insu5177/temperature-compensated-mosfet-current-sensing/results/figures/u1_schematic.png

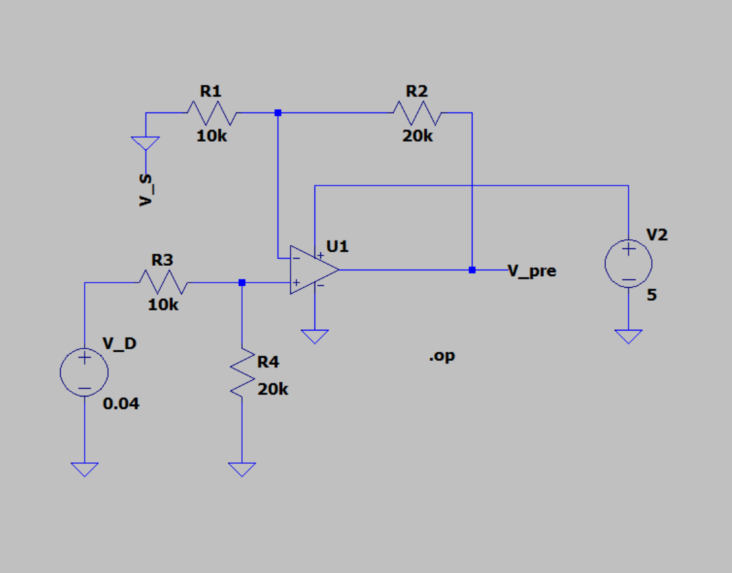
results/figures/u1_schematic.png
