insu5177/temperature-compensated-mosfet-current-sensing/circuits/vds_sensing/u1_vds_sensing(offset -1V).asc

R1: res; 10k
R2: res; 20k
R3: res; 10k
R4: res; 20k
U1: UniversalOpAmp2
V1: voltage; 5
V_D1: voltage; 0.04
Vos1: voltage; -1
Named nets: 0, V_S, V_pre
.op
