insu5177/temperature-compensated-mosfet-current-sensing/circuits/compensated_system/compensated_system.asc

R1: res; 10k
R2: res; 20k
R3: res; 10k
R4: res; 20k
R5: res; 718
R6: res; {10k*exp(3950*(1/(Ts+273.15)-1/298.15))}
R7: res; 528
U1: UniversalOpAmp2
U2: UniversalOpAmp2
V2: voltage; 5
V_D: voltage; 0.15
Named nets: 0, V_S, V_pre, V_final
.op
.step param Ts list 25 50 75 100 125 150 175
.meas op Vpre_value PARAM V(V_pre)
.meas op Vfinal_value PARAM V(V_final)
