insu5177/temperature-compensated-mosfet-current-sensing/circuits/ntc_compensation/ntc_compensation.asc

R1: res; 718
R2: res; 528
RNTC: res; {10k*exp(3950*(1/(temp+273.15)-1/298.15))}
V1: voltage; 1
Named nets: 0, Vcomp
.op
.step param temp list 25 50 75 100 125 150 175
.meas op Vcomp_value FIND V(vcomp)
