insu5177/temperature-compensated-mosfet-current-sensing/circuits/vds_sensing/u1_vds_sensing.asc

R1: res; 10k
R2: res; 20k
R3: res; 10k
R4: res; 20k
U1: UniversalOpAmp2
V2: voltage; 5
V_D: voltage; 0.04
Named nets: 0, V_S, V_pre
.op
