insu5177/temperature-compensated-mosfet-current-sensing/data/processed/integrated_test_inputs.csv

I_true (A) | Tc (°C) | Tj (°C) | Ts (°C) | VDS (V)
25 | 25 | 25.3919463625 | 25.3919463625 | 0.0373283892725
25 | 50 | 50.44465214097736 | 50.44465214097736 | 0.042347823471015
25 | 75 | 75.50274749044773 | 75.50274749044773 | 0.0478807143475164
25 | 100 | 100.57124446507927 | 100.57124446507927 | 0.0544042360055714
25 | 125 | 125.64252393036124 | 125.64252393036124 | 0.0611927571791083
25 | 150 | 150.72182688926932 | 150.72182688926932 | 0.0687454211423515
50 | 25 | 26.57775219112 | 26.57775219112 | 0.075131100876448
50 | 50 | 51.7910478825512 | 51.7910478825512 | 0.0852880610683225
50 | 75 | 77.0276392086552 | 77.0276392086552 | 0.0965543723885007
50 | 100 | 102.3046311950746 | 102.3046311950746 | 0.1097445008453402
50 | 125 | 127.59468794312 | 127.59468794312 | 0.123556812765872
50 | 150 | 152.9186702332368 | 152.9186702332368 | 0.138984695758601
75 | 25 | 28.58793655166204 | 28.58793655166204 | 0.1139027619309972
75 | 50 | 54.07739325998212 | 54.07739325998212 | 0.1294410795515882
75 | 75 | 79.62603503637426 | 79.62603503637426 | 0.1468583073283719
75 | 100 | 105.2608535043942 | 105.2608535043942 | 0.1670112913385592
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
