insu5177/temperature-compensated-mosfet-current-sensing/data/processed/mosfet_test_cases.csv

I_true (A) | Tc (°C) | Tj (°C) | Rds (mΩ) | Ploss (W) | VDS (V) | I_fixed (A) | Error (A) | Error (%)
25 | 25 | 25.3919463625 | 1.4931355709 | 0.9332097318125 | 0.0373283892725 | 25.052610249999997 | 0.052610249999997194 | 0.21044099999998878
25 | 50 | 50.44465214097736 | 1.6939129388406007 | 1.0586955867753753 | 0.04234782347101502 | 28.421358034238267 | 3.421358034238267 | 13.685432136953068
25 | 75 | 75.50274749044773 | 1.9152285739006563 | 1.19701785868791 | 0.04788071434751641 | 32.13470761578282 | 7.134707615782823 | 28.538830463131294
25 | 100 | 100.57124446507929 | 2.176169440222856 | 1.3601059001392852 | 0.054404236005571406 | 36.512910070853295 | 11.512910070853295 | 46.05164028341318
25 | 125 | 125.64252393036125 | 2.447710287164335 | 1.5298189294777094 | 0.061192757179108374 | 41.06896454973717 | 16.068964549737167 | 64.27585819894867
25 | 150 | 150.72182688926932 | 2.749816845694063 | 1.7186355285587893 | 0.06874542114235158 | 46.13786653849099 | 21.13786653849099 | 84.55146615396396
50 | 25 | 26.57775219112 | 1.50262201752896 | 3.7565550438224 | 0.075131100876448 | 50.423557635200005 | 0.4235576352000052 | 0.8471152704000104
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
