insu5177/temperature-compensated-mosfet-current-sensing/results/tables/abc_24case_comparison.csv

I_true (A) | Tc (°C) | I_est_A | 오차_A(A) | 오차율_A(%) | I_est_B | 오차_B(A) | 오차율_B(%) | I_est_C_Tj | 오차_C_Tj(A) | 오차율_C_Tj(%)
25 | 25 | 25.055100671140938 | 0.05510067114093786 | 0.22040268456375145 | 24.843513964956177 | -0.15648603504382308 | -0.6259441401752923 | 24.9263939458842 | -0.07360605411579968 | -0.2944242164631987
25 | 50 | 28.423825503355705 | 3.4238255033557046 | 13.69530201342282 | 28.183790402544766 | 3.1837904025447656 | 12.735161610179063 | 25.69086885128864 | 0.6908688512886414 | 2.7634754051545656
25 | 75 | 32.13718120805369 | 7.13718120805369 | 28.548724832214763 | 31.865787354677277 | 6.865787354677277 | 27.463149418709108 | 25.14203612479475 | 0.1420361247947497 | 0.5681444991789988
25 | 100 | 36.515436241610736 | 11.515436241610736 | 46.061744966442944 | 36.20706865687533 | 11.207068656875329 | 44.828274627501315 | 24.411865495823516 | -0.5881345041764838 | -2.3525380167059353
25 | 125 | 41.071476510067114 | 16.071476510067114 | 64.28590604026846 | 40.72463382334347 | 15.724633823343467 | 62.89853529337387 | 24.075105304490616 | -0.9248946955093835 | -3.699578782037534
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
