insu5177/temperature-compensated-mosfet-current-sensing/results/tables/sensor_temperature_comparison.csv

I_true (A) | Tc (°C) | I_est_C_Tj | 오차_C_Tj(A) | 오차율_C_Tj(%) | I_est_C_Tc | 오차_C_Tc(A) | 오차율_C_Tc(%)
25 | 25 | 24.9263939458842 | -0.07360605411579968 | -0.2944242164631987 | 24.952880702505894 | -0.04711929749410615 | -0.1884771899764246
25 | 50 | 25.69086885128864 | 0.6908688512886414 | 2.7634754051545656 | 25.747090740344113 | 0.7470907403441132 | 2.9883629613764526
25 | 75 | 25.14203612479475 | 0.1420361247947497 | 0.5681444991789988 | 25.222031841222243 | 0.2220318412222433 | 0.8881273648889733
25 | 100 | 24.411865495823516 | -0.5881345041764838 | -2.3525380167059353 | 24.495002498750623 | -0.5049975012493775 | -2.01999000499751
25 | 125 | 24.075105304490616 | -0.9248946955093835 | -3.699578782037534 | 24.144677661169418 | -0.8553223388305824 | -3.4212893553223296
25 | 150 | 24.6536017705433 | -0.3463982294566996 | -1.3855929178267985 | 24.706825158849146 | -0.29317484115085435 | -1.1726993646034174
50 | 25 | 50.0 | 0.0 | 0.0 | 50.21810523309774 | 0.218105233097738 | 0.43621046619547593
50 | 50 | 51.390376240451204 | 1.3903762404512037 | 2.7807524809024073 | 51.85014635539373 | 1.8501463553937327 | 3.700292710787465
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
