insu5177/temperature-compensated-mosfet-current-sensing/results/error_comparison.png

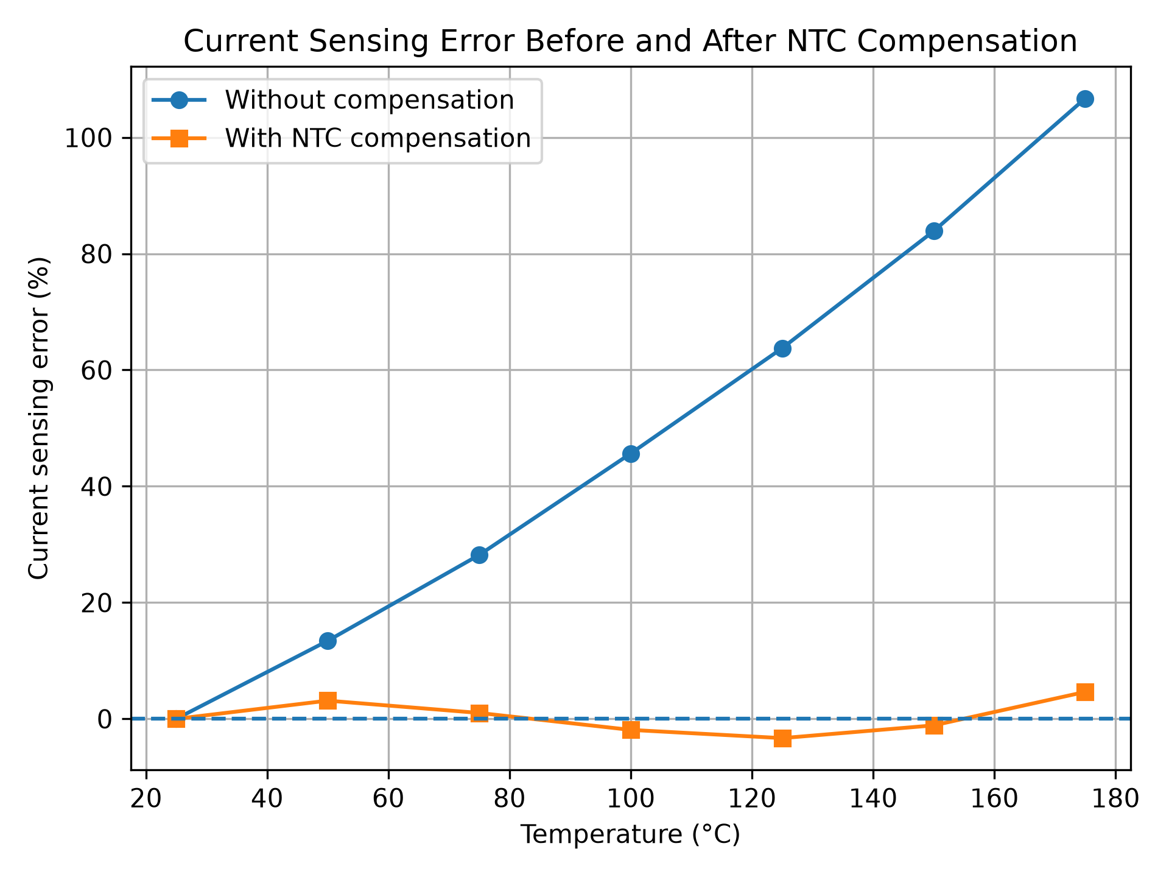
results/error_comparison.png
