insu5177/temperature-compensated-mosfet-current-sensing/results/error_rate_4cases_comparison.png

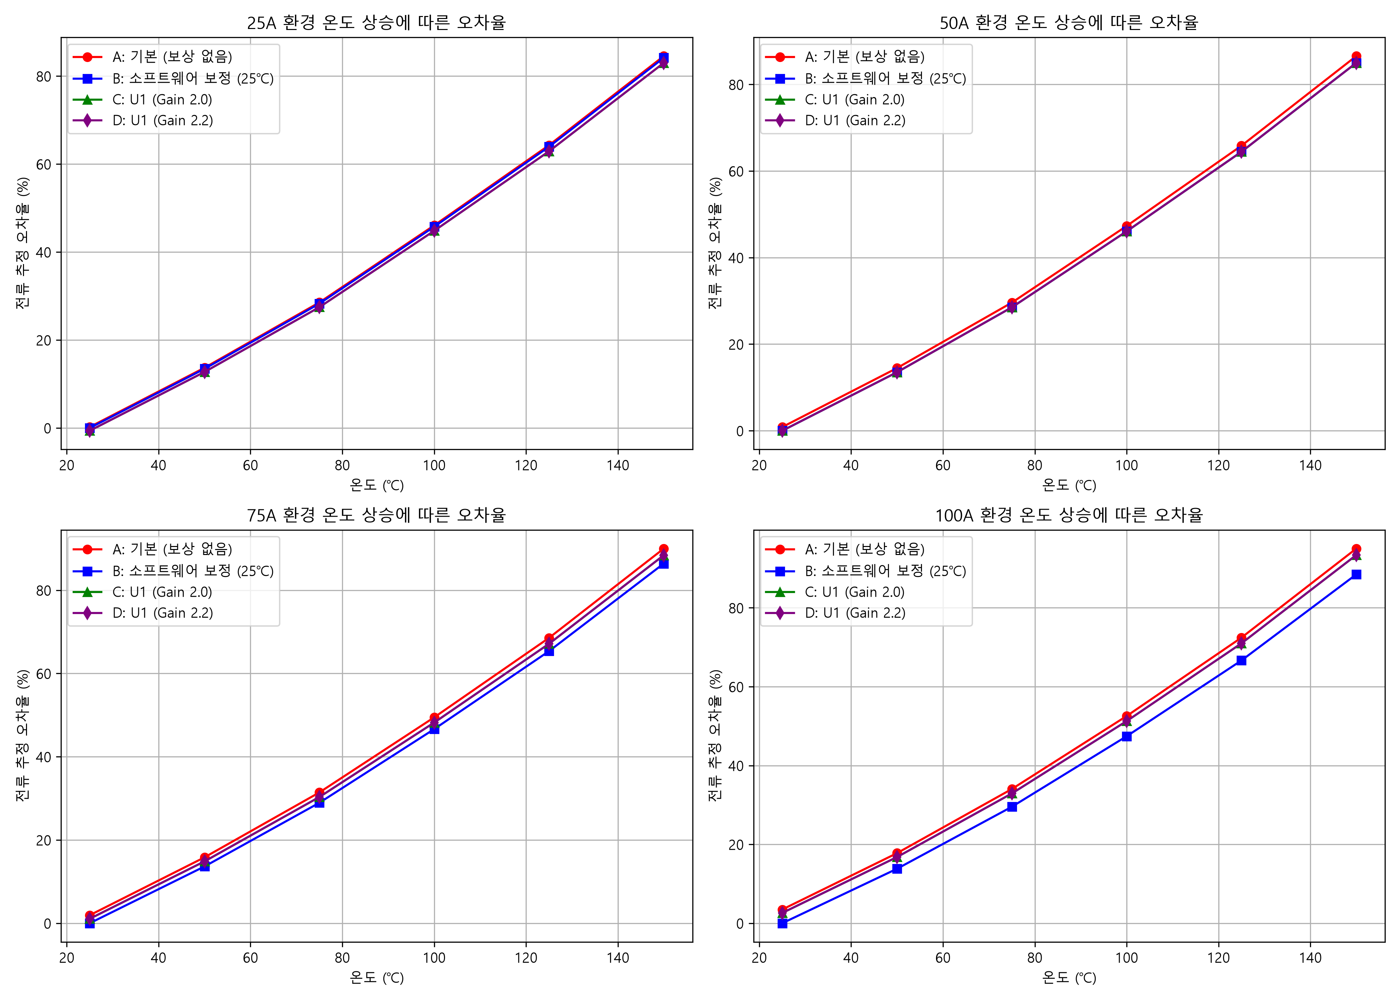
results/error_rate_4cases_comparison.png
