insu5177/temperature-compensated-mosfet-current-sensing/results/figures/compensated_system.png

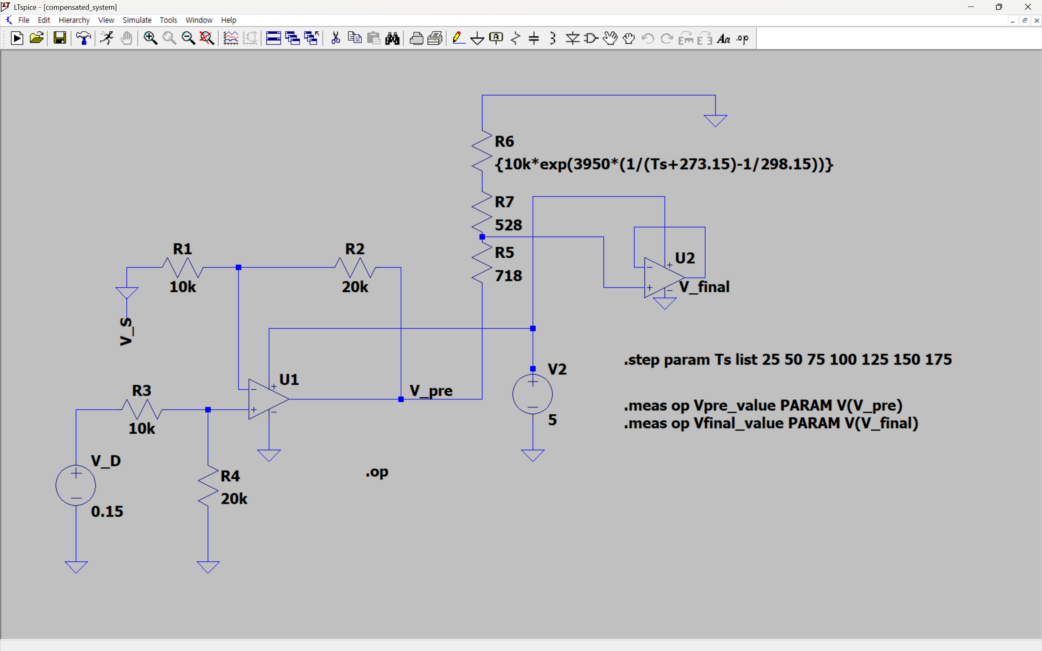
results/figures/compensated_system.png
