insu5177/temperature-compensated-mosfet-current-sensing/results/figures/current_estimation_error_vs_tc.png

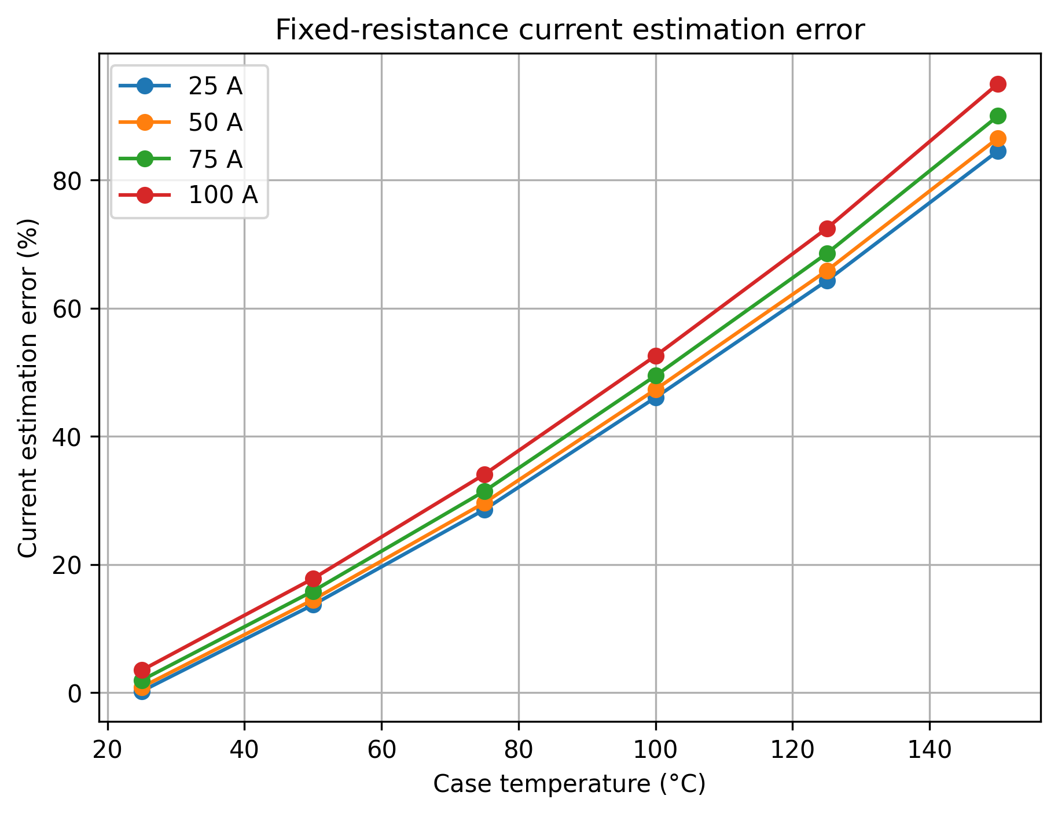
results/figures/current_estimation_error_vs_tc.png
