insu5177/temperature-compensated-mosfet-current-sensing/results/figures/u1_24case_validation.png

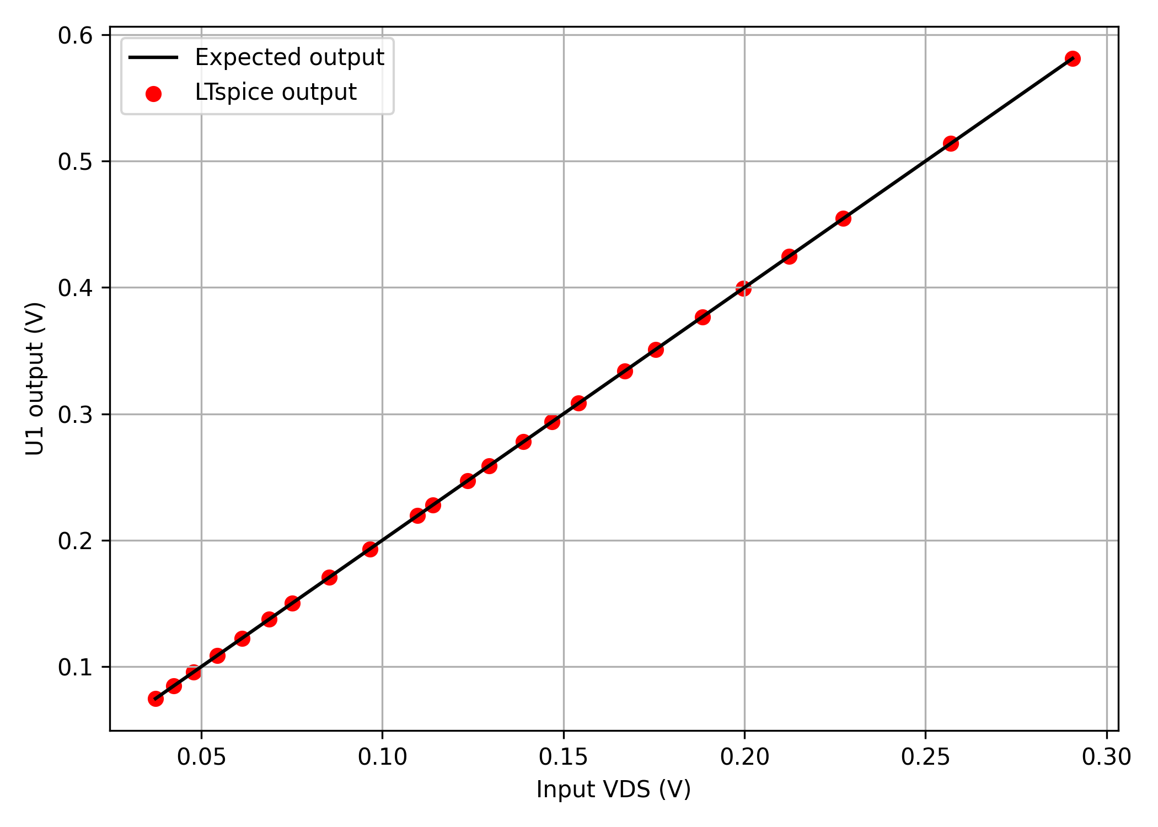
results/figures/u1_24case_validation.png
