insu5177/temperature-compensated-mosfet-current-sensing/(commit log)

2026-09-09 Expand README with project details and guidelines
    Added detailed project overview, objectives, roles, workflow, tools, and precautions for the temperature-compensated MOSFET current sensing system.
2026-09-09 Add existing MOSFET analysis notebooks and source data
    [RDSon_vs_Tj.xlsx, mosfet_parameters.xlsx]
2026-09-09 Add MOSFET on-resistance temperature data as CSV
    [rds_vs_temperature.csv]
2026-09-09 Document MOSFET data sources and modeling assumptions
2026-09-10 Organize multi-current sensing results into a DataFrame
2026-09-10 Add multi-current sensing error analysis and interpret results
2026-09-13 Export sensing test cases and error comparison figure
    [mosfet_test_cases.csv]
2026-09-13 Document MOSFET test data usage and modeling assumptions
2026-09-13 Add U1 circuit and three-point DC test results
2026-09-13 WIP: Compare MOSFET current sensing error (Case A, B, C)
2026-09-14 Add U1 DC validation results and interpretation
    [u1_dc_validation.csv]
2026-09-19 Add three-point U1 DC validation results
    [u1_dc_validation.csv]
2026-09-19 Add U1 validation table and plot for 24 test cases
    [u1_24case_validation.csv]
2026-09-20 Add NTC temperature compensation model
2026-09-20 Add current sensing error comparison
    [error_comparison.csv]
2026-09-20 feat(data): add u1_24case_outputs.csv for mosfet test cases
    [u1_24case_outputs.csv]
2026-09-20 feat(data): add u1_24case_outputs_gain2.2.csv with 2.2x gain
    [u1_24case_outputs_gain2.2.csv]
2026-09-20 feat: add Case A-D error rate comparison plot using U1 Gain 2.0 and 2.2 data
2026-09-20 Add integrated NTC compensation circuit and update error analysis
    [error_comparison.csv]
2026-09-21 Add integrated test inputs with matched sensor temperature and update test plan
    [integrated_test_inputs.csv]
2026-09-21 Add case-temperature sensor inputs for mismatch testing
    [integrated_test_inputs_ts_tc.csv]
2026-09-25 Add integrated 24-case simulation results
    [integrated_24case_outputs.csv]
2026-09-26 Validate integrated circuit outputs under matched sensor temperature
2026-09-27 Add 24-case outputs for Ts=Tc condition
    [integrated_24case_outputs_ts_tc.csv]
2026-09-28 feat: add Vos voltage source for U1 offset validation test
2026-09-28 chore: update Vos voltage value to +1V in u1_offset_test.asc
2026-09-28 Add ABC calibration and sensor temperature mismatch analysis
    [abc_24case_comparison.csv, sensor_temperature_comparison.csv]
2026-09-28 feat: Vos 오프셋 변동에 따른 U1 출력 분석 결과 정리
    U1 차동 증폭 회로에 +-1mV의 입력 오프셋 전압(Vos)을 인가한 결과, 오프셋 전압에 회로의 게인이 곱해지면서 출력 전압(V_pre)에 심각한 오차가 발생함을 확인했습니다. Vos = 0mV 기준 출력인 0.08V 대비 Vos = +1mV 적용 시 1.08V로 상승하였으며, 이는 역산되는 전류 추정값(I_raw)에 막대한 왜곡을 유발합니다. 따라서 미세한 Vos로 인한 센싱 오차를 상쇄하고 측정 신뢰성을 확보하기 위해서는 후속 단계인 50A 한 점 보정(Calibration) 알고리즘 적용이 필수적입니다.
2026-09-28 Clarify calibration labels and error reporting
2026-09-28 feat: add U1 offset output simulation data (u1_offset_outputs.csv)
    [u1_offset_outputs.csv]
2026-09-28 refactor: remove external voltage source and set internal Vos parameter on U1
